lhr-solar/PS-HVCarrierPCB/hardware/HV_Carrier/BOM/PS-HVCarrier-bom.csv

Reference | Qty | Value | DNP | Footprint | LCSC P/N | P/N
C1,C6,C7,C11,C12,C13,C15,C16,C17,C50,C84,C87 | 12 | 0.1u |  | Capacitor_SMD:C_0603_1608Metric_Pad1.08x0.95mm_HandSolder | C14663 | MLASH168SB7104KTNA01
C2,C25,C44,C58,C67,C76 | 6 | 1u |  | Capacitor_SMD:C_0603_1608Metric_Pad1.08x0.95mm_HandSolder | C15849 | MLASU168SB5105KTNA01
C3 | 1 | 220n |  | Capacitor_SMD:C_0603_1608Metric_Pad1.08x0.95mm_HandSolder | C344195 | MSASU168SB7224KTNB25
C4,C26,C45,C46,C59,C68,C77 | 7 | 10n |  | Capacitor_SMD:C_0603_1608Metric_Pad1.08x0.95mm_HandSolder |  | MSASH168SB5103KTNA01
C5,C8,C9,C10,C14,C27,C30 | 7 | 10u |  | Capacitor_SMD:C_0805_2012Metric_Pad1.18x1.45mm_HandSolder | C440198 | GRM21BR61H106KE43K
C18,C51,C60,C69 | 4 | 100p |  | Capacitor_SMD:C_0603_1608Metric_Pad1.08x0.95mm_HandSolder |  | MMARQ167SCG101JTRA18
C19,C22,C24,C49,C52,C55,C57,C61,C64,C66,C70,C73,C75,C82,C83,C85,C86 | 17 | 1n |  | Capacitor_SMD:C_0603_1608Metric_Pad1.08x0.95mm_HandSolder |  | MLASU063SB7102KFNA01
C20,C21,C23,C42,C43,C47,C48,C53,C54,C56,C62,C63,C65,C71,C72,C74,C89 | 17 | 100n |  | Capacitor_SMD:C_0603_1608Metric_Pad1.08x0.95mm_HandSolder | C15849 | MLASH168SB7104KTNA01
C28,C29 | 2 | 26p |  | Capacitor_SMD:C_0603_1608Metric_Pad1.08x0.95mm_HandSolder | C92670 | 0603N270F500CT
C31,C32,C33,C34,C35,C37,C39,C40,C41,C78,C79,C80,C81 | 13 | 0.1uF |  | Capacitor_SMD:C_0603_1608Metric_Pad1.08x0.95mm_HandSolder | C14663 | MLASH168SB7104KTNA01
C36,C38 | 2 | 1uF |  | Capacitor_SMD:C_0603_1608Metric_Pad1.08x0.95mm_HandSolder | C15849 | MLASU168SB5105KTNA01
C88 | 1 | 4.7u |  | Capacitor_SMD:C_0805_2012Metric_Pad1.18x1.45mm_HandSolder | C6962403 | 08055D475KAT4A
C90 | 1 | 100n |  | Capacitor_SMD:C_0603_1608Metric | C6666325 | MLASH168SB7104KTNA01
C91,C92 | 2 | 22u |  | Capacitor_SMD:C_1210_3225Metric_Pad1.33x2.70mm_HandSolder | C778721 | GMK325BJ226MM-P
C93 | 1 | 3.3u |  | Capacitor_SMD:C_0805_2012Metric_Pad1.18x1.45mm_HandSolder | C342775 | C2012X5R1H335K125AB
D1,D2,D3,D4 | 4 | LED |  | LED_SMD:LED_0603_1608Metric_Pad1.05x0.95mm_HandSolder |  | NCD0603R1
D5 | 1 | SMBJ15CA |  | Diode_SMD:D_SMB | C669039 | SMBJ15CA
D6 | 1 | SMAF4758A |  | LHRS_Passives:SODFL5026X125N |  | SMAF4758A
D7 | 1 | SBA130CH-AU_R1_000A1 |  | Diode_SMD:D_SOD-323_HandSoldering | C191023 | SBA130CH-AU_R1_000A1
D8 | 1 | D_Schottky |  | Diode_SMD:D_SOD-123 | C82544 | BAT760-7
D9 | 1 | TPD2EUSB30DRTR |  | LHRS_ICs:TPD2EUSB30DRTR | C97502 | TPD2EUSB30DRTR
D10 | 1 | RGB_LED |  | LHRS_Special:RGB_LED | C264519 | 19-337/R6GHBHC-A01/2T
D11 | 1 | TVS |  | Diode_SMD:D_SOD-323 | C725495 | PESD15VL1BA
D12 | 1 | LED |  | LED_SMD:LED_0603_1608Metric | C125103 | LTST-C193TBKT-5A
D13,D14,D15,D16 | 4 |  |  | Diode_SMD:D_SOD-123F |  | 576-SMF3.3
D17,D18,D19,D20,D21,D22,D23,D24,D25,D26 | 10 | TVS |  | Diode_SMD:D_SOD-123F |  | 576-SMF3.3
F1 | 1 | 1A |  | LHRS_Power:Fuse-3557-2 | C3205238 | 3557-2
FB1,FB2 | 2 | FerriteBead |  | Capacitor_SMD:C_0603_1608Metric_Pad1.08x0.95mm_HandSolder | C354394 | BLM18PG121SH1D
IC1 | 1 | LM74502DDFR |  | LHRS_Power:LM74502DDFR | C3236215 | LM74502DDFR
IC2,IC3 | 2 | TCAN3413DR |  | LHRS_Passives:TCAN3413DR | C22433320 | TCAN3413DR
J1 | 1 | Shunt Breakout |  | LHRS_Connectors:Molex_Nano-Fit_105309-xx03_1x03_P2.50mm_Vertical |  | 1053091103
J2 | 1 | Hall Breakout |  | LHRS_Connectors:Molex_Nano-Fit_105309-xx04_1x04_P2.50mm_Vertical |  | 1053091104
J3 | 1 | IMD_Conn |  | 1053091108:CONN_SD-105309-100_08_MOL |  | IPD1-08-S-K
J4 | 1 | Voltage Tap |  | LHRS_Connectors:Molex_Nano-Fit_105309-xx05_1x05_P2.50mm_Vertical |  | 1053091105
J5 | 1 | BPS Conn |  | LHRS_Connectors:Molex_Nano-Fit_105309-xx05_1x05_P2.50mm_Vertical |  | 1053091105
J6 | 1 | USB_C_Receptacle_USB2.0_16P |  | LHRS_Connectors:USB_C_Receptacle_GCT_USB4105-xx-A_16P_TopMnt_Horizontal |  | USB4105-GF-A-120
J7 | 1 | SWD_Header |  | LHRS_Connectors:SWD_Conn |  | 0878320406
J8 | 1 | SWD |  | Connector_PinHeader_2.54mm:PinHeader_1x04_P2.54mm_Vertical
J9 | 1 | LZSR 80-P |  | LHRS_Connectors:Molex_Nano-Fit_105309-xx05_1x05_P2.50mm_Vertical |  | 1053091105
J10 | 1 | Shunt Conn |  | LHRS_Connectors:Molex_Nano-Fit_105309-xx04_1x04_P2.50mm_Vertical |  | 1053091104
J11 | 1 | SSA-2-100A | DNP |  |  | 1053071204
J12 | 1 | Discharge Vin |  | LHRS_Connectors:Molex_Nano-Fit_105309-xx02_1x02_P2.50mm_Vertical |  | 1053091102
J13 | 1 | Charge Vin |  | LHRS_Connectors:Molex_Nano-Fit_105309-xx02_1x02_P2.50mm_Vertical |  | 1053091102
JP1,JP2 | 2 | TRM |  | Connector_PinHeader_2.54mm:PinHeader_1x02_P2.54mm_Vertical
L1 | 1 | 8.2u |  | LHRS_Passives:74439369082 |  | 74439369082
Q1,Q2 | 2 | PSMN012-100YS |  | Package_TO_SOT_SMD:LFPAK56 | C20443035 | PSMN012-100YSFX
R1,R5 | 2 | 470 |  | Resistor_SMD:R_0603_1608Metric_Pad0.98x0.95mm_HandSolder |  | CRCW1206470RFKEA
R2,R3 | 2 | 150 |  | Resistor_SMD:R_0603_1608Metric_Pad0.98x0.95mm_HandSolder |  | CRCW0603150RFKEC
R4 | 1 | 2.1k |  | Resistor_SMD:R_0603_1608Metric_Pad0.98x0.95mm_HandSolder |  | CRCW06032K10FKEA
R6 | 1 | 0 | DNP | Resistor_SMD:R_0603_1608Metric_Pad0.98x0.95mm_HandSolder |  | CRCW06030000Z0EE
R7,R27,R32,R35,R36,R37,R43,R44,R47,R49,R73,R74,R75,R76,R77,R78,R79,R80,R81,R82,R83,R84,R85 | 23 | 10k |  | Resistor_SMD:R_0603_1608Metric_Pad0.98x0.95mm_HandSolder | C25804 | CRCW060310K0FKEI
R8 | 1 | 33 |  | Resistor_SMD:R_0603_1608Metric_Pad0.98x0.95mm_HandSolder | C844927 | CRCW060333R0FKEA
R9,R11 | 2 | 100k |  | Resistor_SMD:R_0603_1608Metric_Pad0.98x0.95mm_HandSolder | C844916 | CRCW0603100KFKED
R10 | 1 | 7.32k |  | Resistor_SMD:R_0603_1608Metric_Pad0.98x0.95mm_HandSolder | C843967 | CRCW06037K32FKEA
R12 | 1 | 15.8k |  | Resistor_SMD:R_0603_1608Metric_Pad0.98x0.95mm_HandSolder | C2090646 | CRCW0603137KFKEA
R13,R14,R15,R16 | 4 | 60 |  | Resistor_SMD:R_0603_1608Metric_Pad0.98x0.95mm_HandSolder | C166918 | CRCW060360R4FKEA
R17,R18,R19,R50,R51,R52,R57,R58,R59,R64,R65,R66 | 12 | 500k |  | Resistor_SMD:R_0805_2012Metric_Pad1.20x1.40mm_HandSolder |  | RNCF0805BTE500K
R20,R38,R39,R40,R45,R46,R53,R60,R67 | 9 | 20k |  | Resistor_SMD:R_0603_1608Metric_Pad0.98x0.95mm_HandSolder |  | CR0603-FX-2002ELF
R21,R54,R61,R68 | 4 | 47k |  | Resistor_SMD:R_0603_1608Metric_Pad0.98x0.95mm_HandSolder |  | CRCW060347K0FKECC
R22,R23,R55,R56,R62,R63,R69,R70 | 8 | 10 |  | Resistor_SMD:R_0603_1608Metric_Pad0.98x0.95mm_HandSolder |  | CRCW060310R0FKEE
R24,R25 | 2 | 5.1k |  | Resistor_SMD:R_0603_1608Metric_Pad0.98x0.95mm_HandSolder | C23186 | 0603WAF5101T5E
R26,R28,R29,R33 | 4 | 1k |  | Resistor_SMD:R_0603_1608Metric_Pad0.98x0.95mm_HandSolder | C21190 | CRCW06031K00FKEI
R30,R31 | 2 | 22 |  | Resistor_SMD:R_0603_1608Metric_Pad0.98x0.95mm_HandSolder | C2930077 | RC0603FR-0722RL
R34 | 1 | 0 |  | Resistor_SMD:R_0603_1608Metric_Pad0.98x0.95mm_HandSolder | C21189 | CRCW06030000Z0EE
R41,R42 | 2 | 100 |  | Resistor_SMD:R_0603_1608Metric_Pad0.98x0.95mm_HandSolder |  | 0603WAF1000T5E
R48 | 1 | 90.9k |  | Resistor_SMD:R_0603_1608Metric_Pad0.98x0.95mm_HandSolder |  | RMCF0603FT90K9
R71 | 1 | 16k |  | Resistor_SMD:R_0603_1608Metric_Pad0.98x0.95mm_HandSolder |  | CRCW060316K0FKTA
R72 | 1 | 4.7k |  | Resistor_SMD:R_0603_1608Metric_Pad0.98x0.95mm_HandSolder |  | CRCW06034K70FKEA
R86 | 1 | 100k |  | Resistor_SMD:R_0603_1608Metric | C25803 | CRCW0603100KFKEE
R87 | 1 | 19.1k |  | Resistor_SMD:R_0603_1608Metric | C844132 | CRCW060319K1FKEAHP
S1 | 1 | OS102011MS2QN1 |  | OS102011MS2QN1:OS102011MA1QN1 |  | OS102011MS2QN1
SW1 | 1 | Reset |  | LHRS_Special:TL3365AF180QG | C2886926 | TL3365AF180QG
SW2 | 1 | SW_SPDT |  | LHRS_Special:BootSW | - | 450406020024
TP1 | 1 | HV GND |  | TestPoint:TestPoint_THTPad_D3.0mm_Drill1.5mm
TP3 | 1 | +5V TP |  | TestPoint:TestPoint_THTPad_D3.0mm_Drill1.5mm
TP4 | 1 | GND |  | TestPoint:TestPoint_THTPad_D3.0mm_Drill1.5mm
TP5 | 1 | +12V_Ext TP |  | TestPoint:TestPoint_THTPad_D3.0mm_Drill1.5mm
TP7 | 1 | CC1 |  | TestPoint:TestPoint_THTPad_D3.0mm_Drill1.5mm
TP8 | 1 | CC2 |  | TestPoint:TestPoint_THTPad_D3.0mm_Drill1.5mm
TP9 | 1 | PR_TP |  | TestPoint:TestPoint_THTPad_D3.0mm_Drill1.5mm
TP10 | 1 | HALL_UOUT |  | TestPoint:TestPoint_THTPad_D3.0mm_Drill1.5mm
TP11 | 1 | HALL_UREF |  | TestPoint:TestPoint_THTPad_D3.0mm_Drill1.5mm
TP12 | 1 | HALL_OCD |  | TestPoint:TestPoint_THTPad_D3.0mm_Drill1.5mm
TP13 | 1 | SHUNT_OUTN |  | TestPoint:TestPoint_THTPad_D3.0mm_Drill1.5mm
TP14 | 1 | SHUNT_UREF |  | TestPoint:TestPoint_THTPad_D3.0mm_Drill1.5mm
TP15 | 1 | Scrut Vin+ |  | TestPoint:TestPoint_THTPad_D3.0mm_Drill1.5mm
TP16 | 1 | Scrut Vout |  | TestPoint:TestPoint_THTPad_D3.0mm_Drill1.5mm
TP17 | 1 | Scrut Vin- |  | TestPoint:TestPoint_THTPad_D3.0mm_Drill1.5mm
TP18 | 1 | SHUNT_Vout |  | TestPoint:TestPoint_THTPad_D3.0mm_Drill1.5mm
TP19 | 1 | HV+ IN |  | TestPoint:TestPoint_THTPad_D3.0mm_Drill1.5mm
TP20 | 1 | Motor+ IN |  | TestPoint:TestPoint_THTPad_D3.0mm_Drill1.5mm
TP21 | 1 | HV+_P |  | TestPoint:TestPoint_THTPad_D3.0mm_Drill1.5mm
TP22 | 1 | HV+_N |  | TestPoint:TestPoint_THTPad_D3.0mm_Drill1.5mm
TP23 | 1 | Motor+_P |  | TestPoint:TestPoint_THTPad_D3.0mm_Drill1.5mm
TP24 | 1 | Motor+_N |  | TestPoint:TestPoint_THTPad_D3.0mm_Drill1.5mm
TP25 | 1 | HV+ DIAG |  | TestPoint:TestPoint_THTPad_D3.0mm_Drill1.5mm
TP26 | 1 | Motor+ DIAG |  | TestPoint:TestPoint_THTPad_D3.0mm_Drill1.5mm
TP27 | 1 | Motor- IN |  | TestPoint:TestPoint_THTPad_D3.0mm_Drill1.5mm
TP28 | 1 | HV- IN |  | TestPoint:TestPoint_THTPad_D3.0mm_Drill1.5mm
TP29 | 1 | HV-_P |  | TestPoint:TestPoint_THTPad_D3.0mm_Drill1.5mm
TP30 | 1 | HV-_N |  | TestPoint:TestPoint_THTPad_D3.0mm_Drill1.5mm
TP31 | 1 | Motor-_P |  | TestPoint:TestPoint_THTPad_D3.0mm_Drill1.5mm
TP32 | 1 | Motor- N |  | TestPoint:TestPoint_THTPad_D3.0mm_Drill1.5mm
TP33 | 1 | HV- DIAG |  | TestPoint:TestPoint_THTPad_D3.0mm_Drill1.5mm
TP34 | 1 | Motor- DIAG |  | TestPoint:TestPoint_THTPad_D3.0mm_Drill1.5mm
TP35 | 1 | HV- ADC |  | TestPoint:TestPoint_THTPad_D3.0mm_Drill1.5mm
TP36 | 1 | HV+ ADC |  | TestPoint:TestPoint_THTPad_D3.0mm_Drill1.5mm
TP37 | 1 | Motor+ ADC |  | TestPoint:TestPoint_THTPad_D3.0mm_Drill1.5mm
TP38 | 1 | Motor- ADC |  | TestPoint:TestPoint_THTPad_D3.0mm_Drill1.5mm
TP39 | 1 | V_in_12V |  | TestPoint:TestPoint_THTPad_D3.0mm_Drill1.5mm
TP40 | 1 | CB |  | TestPoint:TestPoint_THTPad_D3.0mm_Drill1.5mm
TP41 | 1 | FB |  | TestPoint:TestPoint_THTPad_D3.0mm_Drill1.5mm
TP42 | 1 | SW |  | TestPoint:TestPoint_THTPad_D3.0mm_Drill1.5mm
U1 | 1 | MCP1826S |  | Package_TO_SOT_SMD:SOT-223-3_TabPin2 | C126055 | MCP1826S-3302E/DB
U2,U3 | 2 | CDSOT23-T24CAN |  | LHRS_ICs:CDSOT23-T24CAN |  | CDSOT23-T24CAN
U4,U7,U8,U9 | 4 | AMC3311QDWERQ1 |  | AMC3311QDWERQ1:DWE0016A-IPC_A |  | AMC3311QDWERQ1
U5 | 1 | STM32G473CETx |  | LHRS_Special:48PinMCU | C730113 | STM32G473CET6
U6,U11,U12 | 3 | TLV9002QDRQ1 |  | Package_SO:SOIC-8_3.9x4.9mm_P1.27mm |  | TLV9002QDRQ1
U10 | 1 | TPS2117DRLR |  | LHRS_Power:TPS2117DRLR |  | TPS2117DRLR
U13 | 1 | LMR51635XDDCR |  | LHRS_ICs:DDC0006A-MFG |  | LMR51635XDDCR
Y1 | 1 | Crystal |  | LHRS_Passives:Crystal_SMD_Abracon_ABM3-2Pin_5.0x3.2mm | C144380 | ABM3-8.000MHZ-D2Y-T
