lhr-solar/PS-HVCarrierPCB/hardware/HV_Carrier/12VBuck.kicad_sch

## KiCad design hardware/HV_Carrier/12VBuck.kicad_sch (2026-09-15)

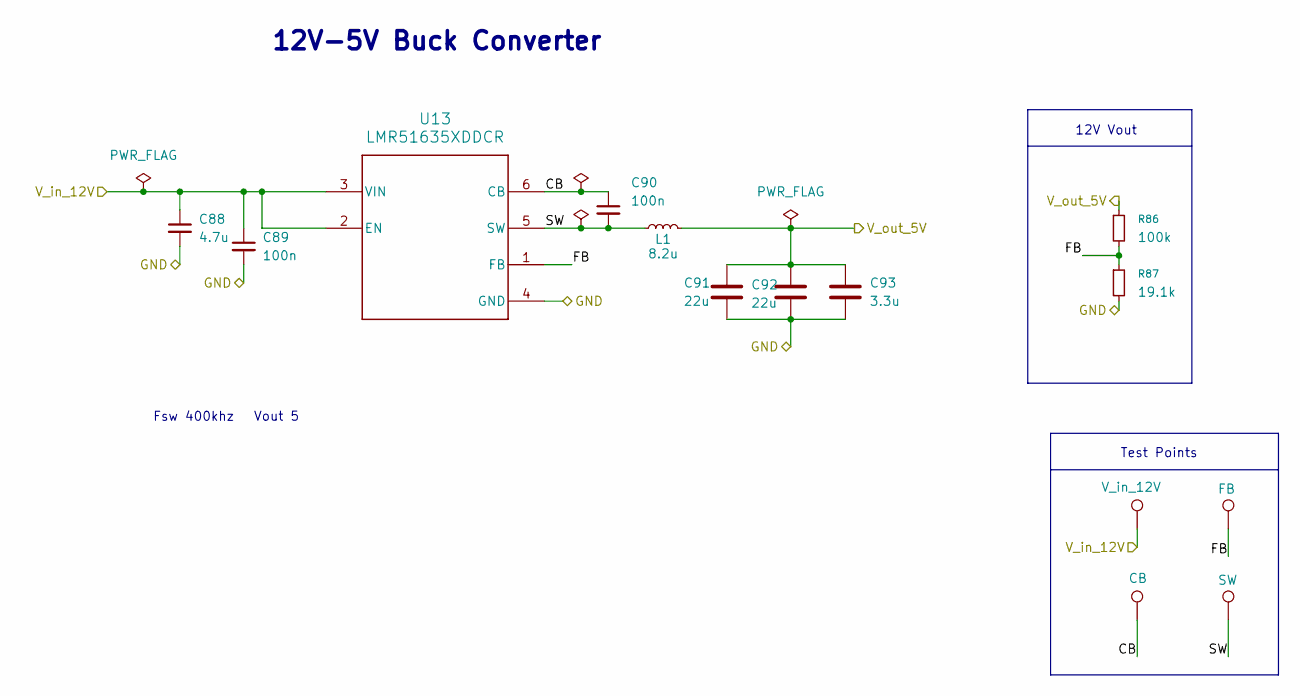
[picture p1: schematic 12VBuck.kicad_sch]

Parts:
C88: 4.7u; C_0805_2012Metric_Pad1.18x1.45mm_HandSolder; LCSC P/N C6962403
C89: 100n; C_0603_1608Metric_Pad1.08x0.95mm_HandSolder; LCSC P/N C15849
C90: 100n; C_0603_1608Metric; LCSC P/N C6666325
C91, C92: 22u; C_1210_3225Metric_Pad1.33x2.70mm_HandSolder; LCSC P/N C778721
C93: 3.3u; C_0805_2012Metric_Pad1.18x1.45mm_HandSolder; LCSC P/N C342775
L1: 8.2u; 74439369082
R86: 100k; R_0603_1608Metric; LCSC P/N C25803
R87: 19.1k; R_0603_1608Metric; LCSC P/N C844132
TP39: V_in_12V; TestPoint_THTPad_D3.0mm_Drill1.5mm
TP40: CB; TestPoint_THTPad_D3.0mm_Drill1.5mm
TP41: FB; TestPoint_THTPad_D3.0mm_Drill1.5mm
TP42: SW; TestPoint_THTPad_D3.0mm_Drill1.5mm
U13: LMR51635XDDCR; DDC0006A-MFG

Connections:
CB: C90.1, TP40.1, U13.6 (CB)
FB: R86.2, R87.1, TP41.1, U13.1 (FB)
GND: C88.2, C89.2, C91.2, C92.2, C93.2, R87.2, U13.4 (GND)
SW: C90.2, L1.1, TP42.1, U13.5 (SW)
V_in_12V: C88.1, C89.1, TP39.1, U13.2 (EN), U13.3 (VIN)
V_out_5V: C91.1, C92.1, C93.1, L1.2, R86.1

Notes on the sheet:
12V Vout
Test Points
Fsw 400khz
Vout 5
12V-5V Buck Converter
