lhr-solar/PS-HVCarrierPCB/hardware/HV_Carrier/AMC3311_Sense.kicad_sch

## KiCad design hardware/HV_Carrier/AMC3311_Sense.kicad_sch (2026-09-15)

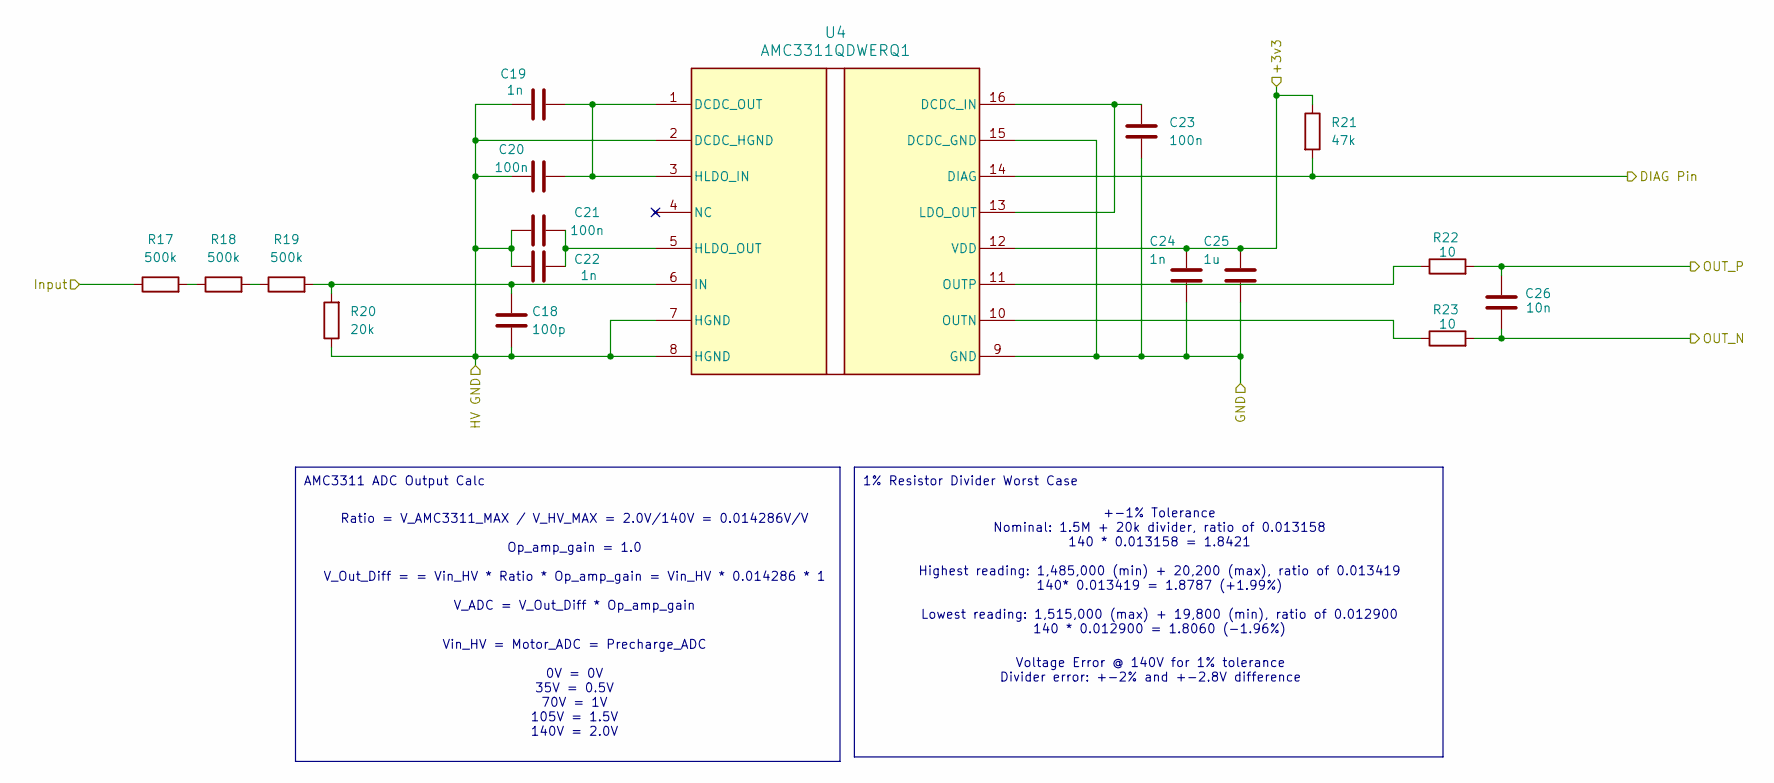
[picture p2: schematic AMC3311_Sense.kicad_sch]

Parts:
C18: 100p; C_0603_1608Metric_Pad1.08x0.95mm_HandSolder
C19, C22, C24: 1n; C_0603_1608Metric_Pad1.08x0.95mm_HandSolder
C20, C21, C23: 100n; C_0603_1608Metric_Pad1.08x0.95mm_HandSolder; LCSC P/N C15849
C25: 1u; C_0603_1608Metric_Pad1.08x0.95mm_HandSolder; LCSC P/N C15849
C26: 10n; C_0603_1608Metric_Pad1.08x0.95mm_HandSolder
R17, R18, R19: 500k; R_0805_2012Metric_Pad1.20x1.40mm_HandSolder
R20: 20k; R_0603_1608Metric_Pad0.98x0.95mm_HandSolder
R21: 47k; R_0603_1608Metric_Pad0.98x0.95mm_HandSolder
R22, R23: 10; R_0603_1608Metric_Pad0.98x0.95mm_HandSolder
U4: AMC3311QDWERQ1; DWE0016A-IPC_A

Connections:
+3v3: C24.1, C25.1, R21.1, U4.12 (VDD)
DIAG Pin: R21.2, U4.14 (DIAG)
GND: C23.2, C24.2, C25.2, U4.9 (GND), U4.15 (DCDC_GND)
HV GND: C18.2, C19.2, C20.1, C21.1, C22.1, R20.1, U4.2 (DCDC_HGND), U4.7 (HGND), U4.8 (HGND)
Input: R17.1
unnamed: C18.1, R19.2, R20.2, U4.6 (IN)
unnamed: C19.1, C20.2, U4.1 (DCDC_OUT), U4.3 (HLDO_IN)
unnamed: C21.2, C22.2, U4.5 (HLDO_OUT)
unnamed: C23.1, U4.13 (LDO_OUT), U4.16 (DCDC_IN)
unnamed: R17.2, R18.1
unnamed: R18.2, R19.1
unnamed: R22.1, U4.11 (OUTP)
unnamed: R23.1, U4.10 (OUTN)
OUT_N: C26.1, R23.2
OUT_P: C26.2, R22.2

Notes on the sheet:
Voltage Error @ 140V for 1% tolerance Divider error: +-2% and +-2.8V difference
+-1% Tolerance Nominal: 1.5M + 20k divider, ratio of 0.013158 140 * 0.013158 = 1.8421 Highest reading: 1,485,000 (min) + 20,200 (max), ratio of 0.013419 140* 0.013419 = 1.8787 (+1.99%) Lowest reading: 1,515,000 (max) + 19,800 (min), ratio of 0.012900 140 * 0.012900 = 1.8060 (-1.96%)
Ratio = V_AMC3311_MAX / V_HV_MAX = 2.0V/140V = 0.014286V/V Op_amp_gain = 1.0 V_Out_Diff = = Vin_HV * Ratio * Op_amp_gain = Vin_HV * 0.014286 * 1 V_ADC = V_Out_Diff * Op_amp_gain
1% Resistor Divider Worst Case
AMC3311 ADC Output Calc
Vin_HV = Motor_ADC = Precharge_ADC 0V = 0V 35V = 0.5V 70V = 1V 105V = 1.5V 140V = 2.0V
