lhr-solar/PS-HVCarrierPCB/hardware/HV_Carrier/Current_Sense.kicad_sch

## KiCad design hardware/HV_Carrier/Current_Sense.kicad_sch (2026-09-15)

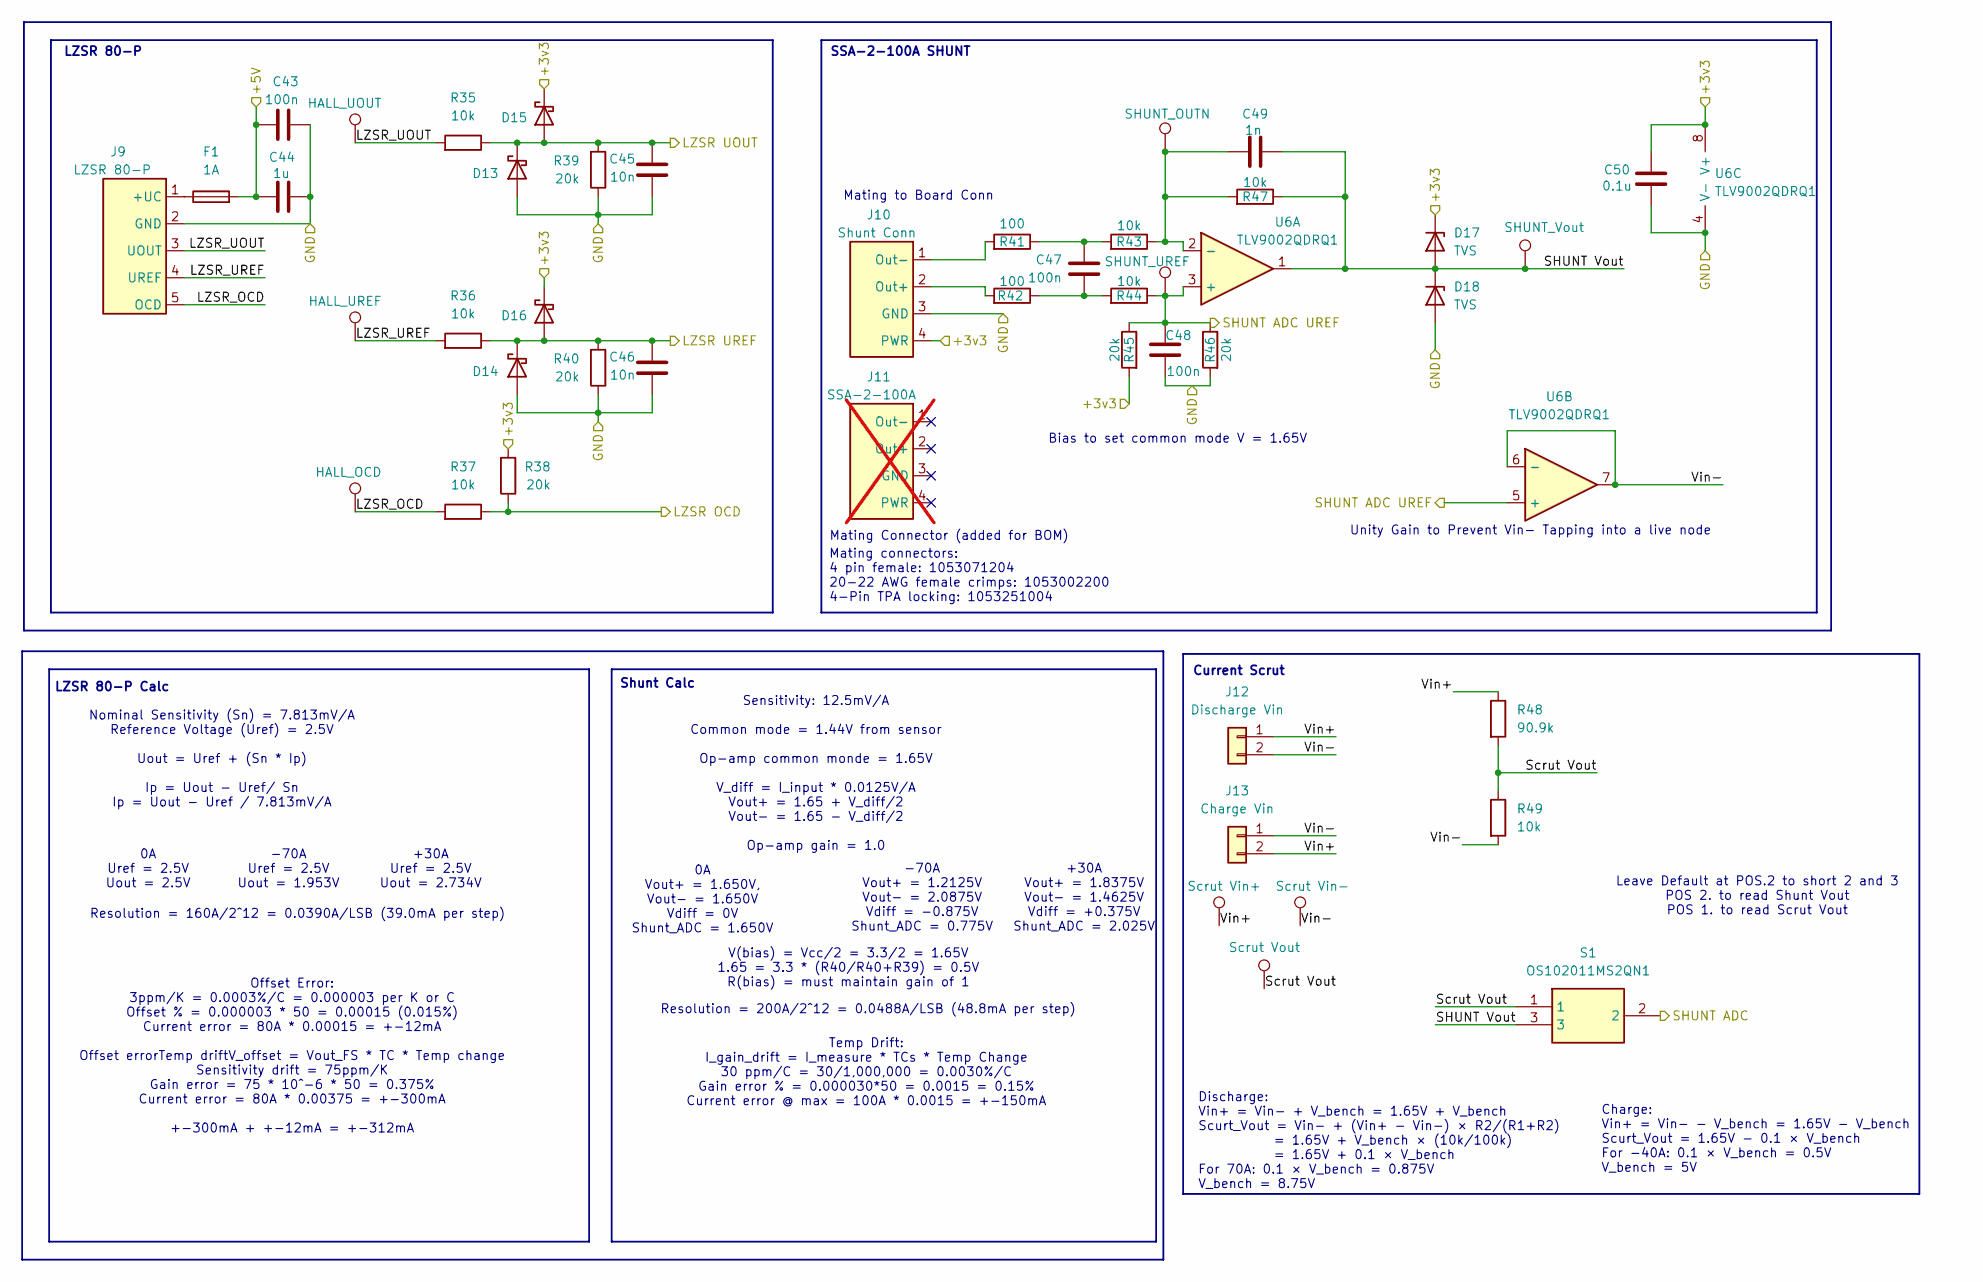
[picture p3: schematic Current_Sense.kicad_sch]

Parts:
C43, C47, C48: 100n; C_0603_1608Metric_Pad1.08x0.95mm_HandSolder; LCSC P/N C15849
C44: 1u; C_0603_1608Metric_Pad1.08x0.95mm_HandSolder; LCSC P/N C15849
C45, C46: 10n; C_0603_1608Metric_Pad1.08x0.95mm_HandSolder
C49: 1n; C_0603_1608Metric_Pad1.08x0.95mm_HandSolder
C50: 0.1u; C_0603_1608Metric_Pad1.08x0.95mm_HandSolder; LCSC P/N C14663
D13, D14, D15, D16: D_SOD-123F
D17, D18: TVS; D_SOD-123F
F1: 1A; Fuse-3557-2; LCSC P/N C3205238
J9: LZSR 80-P; Molex_Nano-Fit_105309-xx05_1x05_P2.50mm_Vertical
J10: Shunt Conn; Molex_Nano-Fit_105309-xx04_1x04_P2.50mm_Vertical
J11: SSA-2-100A; not fitted
J12: Discharge Vin; Molex_Nano-Fit_105309-xx02_1x02_P2.50mm_Vertical
J13: Charge Vin; Molex_Nano-Fit_105309-xx02_1x02_P2.50mm_Vertical
R35, R36, R37, R43, R44, R47, R49: 10k; R_0603_1608Metric_Pad0.98x0.95mm_HandSolder; LCSC P/N C25804
R38, R39, R40, R45, R46: 20k; R_0603_1608Metric_Pad0.98x0.95mm_HandSolder
R41, R42: 100; R_0603_1608Metric_Pad0.98x0.95mm_HandSolder
R48: 90.9k; R_0603_1608Metric_Pad0.98x0.95mm_HandSolder
S1: OS102011MS2QN1; OS102011MA1QN1
TP10: HALL_UOUT; TestPoint_THTPad_D3.0mm_Drill1.5mm
TP11: HALL_UREF; TestPoint_THTPad_D3.0mm_Drill1.5mm
TP12: HALL_OCD; TestPoint_THTPad_D3.0mm_Drill1.5mm
TP13: SHUNT_OUTN; TestPoint_THTPad_D3.0mm_Drill1.5mm
TP14: SHUNT_UREF; TestPoint_THTPad_D3.0mm_Drill1.5mm
TP15: Scrut Vin+; TestPoint_THTPad_D3.0mm_Drill1.5mm
TP16: Scrut Vout; TestPoint_THTPad_D3.0mm_Drill1.5mm
TP17: Scrut Vin-; TestPoint_THTPad_D3.0mm_Drill1.5mm
TP18: SHUNT_Vout; TestPoint_THTPad_D3.0mm_Drill1.5mm
U6: TLV9002QDRQ1; SOIC-8_3.9x4.9mm_P1.27mm

Connections:
+3v3: C50.1, D15.1 (K), D16.1 (K), D17.1 (K), J10.4 (PWR), R38.2, R45.2, U6.8 (V+)
+5V: C43.1, C44.1, F1.1
GND: C43.2, C44.2, C45.2, C46.2, C48.2, C50.2, D13.2 (A), D14.2 (A), D18.2 (A), J9.2 (GND), J10.3 (GND), R39.1, R40.1, R46.2, U6.4 (V-)
LZSR OCD: R37.1, R38.1
LZSR UOUT: C45.1, D13.1 (K), D15.2 (A), R35.1, R39.2
LZSR UREF: C46.1, D14.1 (K), D16.2 (A), R36.1, R40.2
LZSR_OCD: J9.5 (OCD), R37.2, TP12.1
LZSR_UOUT: J9.3 (UOUT), R35.2, TP10.1
LZSR_UREF: J9.4 (UREF), R36.2, TP11.1
unnamed: C47.1, R41.1, R43.2
unnamed: C47.2, R42.1, R44.2
unnamed: C49.2, R43.1, R47.2, TP13.1, U6.2 (-)
unnamed: F1.2, J9.1 (+UC)
unnamed: J10.1 (Out-), R41.2
unnamed: J10.2 (Out+), R42.2
SHUNT ADC: S1.2
SHUNT ADC UREF: C48.1, R44.1, R45.1, R46.1, TP14.1, U6.3 (+), U6.5 (+)
SHUNT Vout: C49.1, D17.2 (A), D18.1 (K), R47.1, S1.3, TP18.1, U6.1
Scrut Vout: R48.2, R49.1, S1.1, TP16.1
Vin+: J12.1, J13.2, R48.1, TP15.1
Vin-: J12.2, J13.1, R49.2, TP17.1, U6.6 (-), U6.7

Notes on the sheet:
LZSR 80-P Calc
Mating to Board Conn
Offset Error: 3ppm/K = 0.0003%/C = 0.000003 per K or C Offset % = 0.000003 * 50 = 0.00015 (0.015%) Current error = 80A * 0.00015 = +-12mA Offset errorTemp driftV_offset = Vout_FS * TC * Temp change Sensitivity drift = 75ppm/K Gain error = 75 * 10^-6 * 50 = 0.375% Current error = 80A * 0.00375 = +-3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
Resolution = 160A/2^12 = 0.0390A/LSB (39.0mA per step)
Resolution = 200A/2^12 = 0.0488A/LSB (48.8mA per step)
Mating connectors: 4 pin female: 1053071204 20-22 AWG female crimps: 1053002200 4-Pin TPA locking: 1053251004
0A Uref = 2.5V Uout = 2.5V
-70A Vout+ = 1.2125V Vout- = 2.0875V Vdiff = -0.875V Shunt_ADC = 0.775V
+30A Vout+ = 1.8375V Vout- = 1.4625V Vdiff = +0.375V Shunt_ADC = 2.025V
Leave Default at POS.2 to short 2 and 3 POS 2. to read Shunt Vout POS 1. to read Scrut Vout
Bias to set common mode V = 1.65V
Sensitivity: 12.5mV/A Common mode = 1.44V from sensor Op-amp common monde = 1.65V V_diff = I_input * 0.0125V/A Vout+ = 1.65 + V_diff/2 Vout- = 1.65 - V_diff/2 Op-amp gain = 1.0
LZSR 80-P
Mating Connector (added for BOM)
V(bias) = Vcc/2 = 3.3/2 = 1.65V 1.65 = 3.3 * (R40/R40+R39) = 0.5V R(bias) = must maintain gain of 1
-70A Uref = 2.5V Uout = 1.953V
+30A Uref = 2.5V Uout = 2.734V
Shunt Calc
SSA-2-100A SHUNT
Charge: Vin+ = Vin- − V_bench = 1.65V − V_bench Scurt_Vout = 1.65V − 0.1 × V_bench For -40A: 0.1 × V_bench = 0.5V V_bench = 5V
Current Scrut
Unity Gain to Prevent Vin- Tapping into a live node
Discharge: Vin+ = Vin- + V_bench = 1.65V + V_bench Scurt_Vout = Vin- + (Vin+ − Vin-) × R2/(R1+R2) = 1.65V + V_bench × (10k/100k) = 1.65V + 0.1 × V_bench For 70A: 0.1 × V_bench = 0.875V V_bench = 8.75V
0A Vout+ = 1.650V, Vout- = 1.650V Vdiff = 0V Shunt_ADC = 1.650V
Nominal Sensitivity (Sn) = 7.813mV/A Reference Voltage (Uref) = 2.5V Uout = Uref + (Sn * Ip) Ip = Uout - Uref/ Sn Ip = Uout - Uref / 7.813mV/A
Temp Drift: I_gain_drift = I_measure * TCs * Temp Change 30 ppm/C = 30/1,000,000 = 0.0030%/C Gain error % = 0.000030*50 = 0.0015 = 0.15% Current error @ max = 100A * 0.0015 = +-150mA
