lhr-solar/PS-HVCarrierPCB/hardware/HV_Carrier/Power_Mux.kicad_sch

## KiCad design hardware/HV_Carrier/Power_Mux.kicad_sch (2026-09-15)

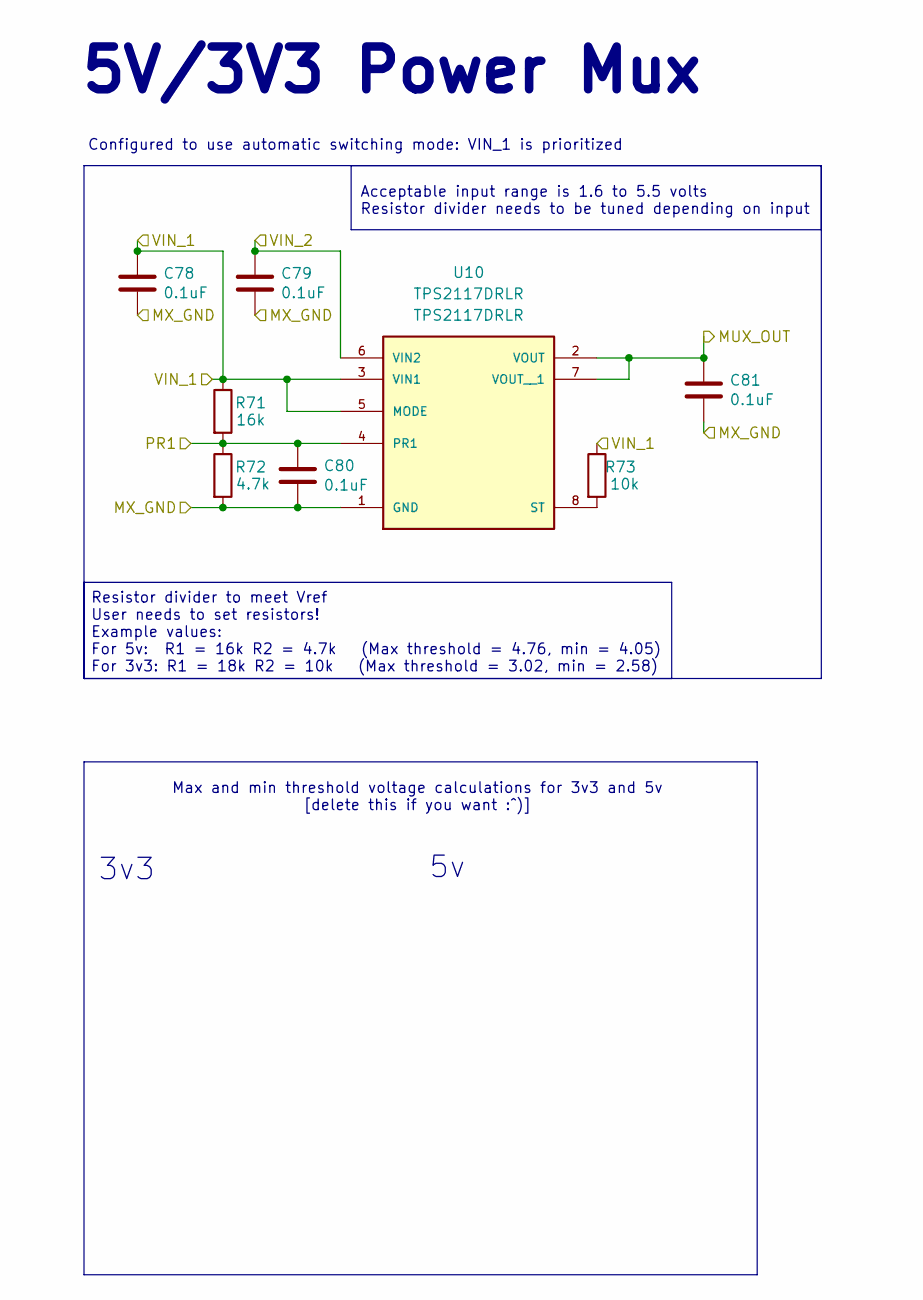
[picture p4: schematic Power_Mux.kicad_sch]

Parts:
C78, C79, C80, C81: 0.1uF; C_0603_1608Metric_Pad1.08x0.95mm_HandSolder; LCSC P/N C14663
R71: 16k; R_0603_1608Metric_Pad0.98x0.95mm_HandSolder
R72: 4.7k; R_0603_1608Metric_Pad0.98x0.95mm_HandSolder
R73: 10k; R_0603_1608Metric_Pad0.98x0.95mm_HandSolder; LCSC P/N C25804
U10: TPS2117DRLR

Connections:
MUX_OUT: C81.1, U10.2 (VOUT), U10.7 (VOUT__1)
MX_GND: C78.2, C79.2, C80.2, C81.2, R72.2, U10.1 (GND)
unnamed: R73.2, U10.8 (ST)
PR1: C80.1, R71.2, R72.1, U10.4 (PR1)
VIN_1: C78.1, R71.1, R73.1, U10.3 (VIN1), U10.5 (MODE)
VIN_2: C79.1, U10.6 (VIN2)

Notes on the sheet:
Max and min threshold voltage calculations for 3v3 and 5v [delete this if you want :^)]
3v3
Configured to use automatic switching mode: VIN_1 is prioritized
Acceptable input range is 1.6 to 5.5 volts Resistor divider needs to be tuned depending on input
Resistor divider to meet Vref User needs to set resistors! Example values: For 5v: R1 = 16k R2 = 4.7k (Max threshold = 4.76, min = 4.05) For 3v3: R1 = 18k R2 = 10k (Max threshold = 3.02, min = 2.58)
5V/3V3 Power Mux
